MarkDannemiller/THOR-Glove/250228-150111-teensy40/docs/SCH_GLOVE-PCB_2025-04-27.pdf

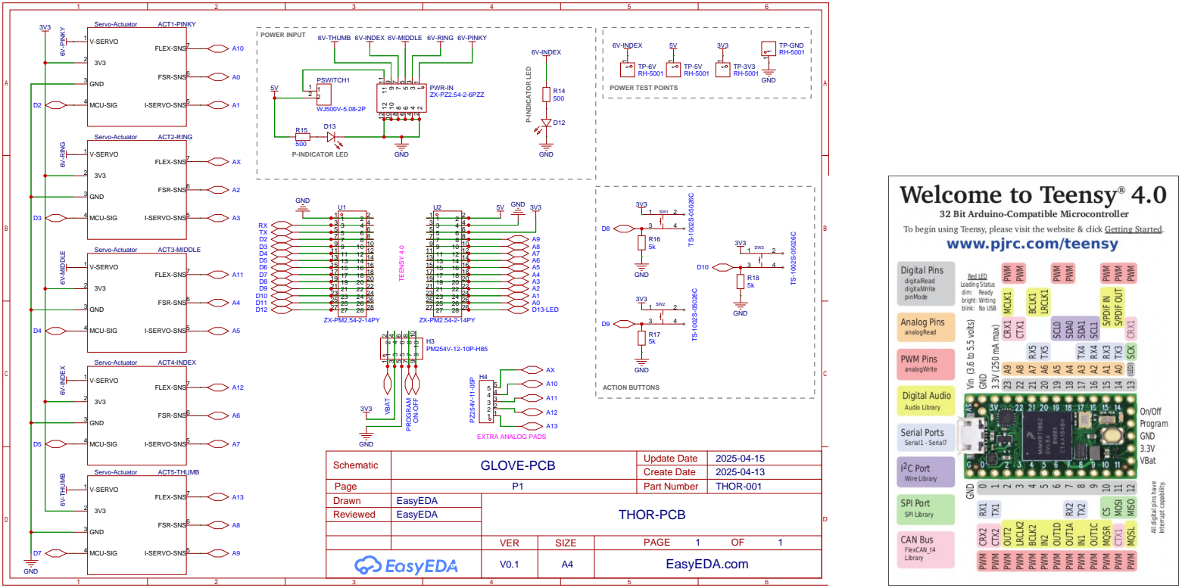
[picture p12: page 1]

6V-THUMB 6V-INDEX 6V-MIDDLE 6V-RING 6V-PINKY

6V-RING 6V-MIDDLE 6V-INDEX 6V-THUMB

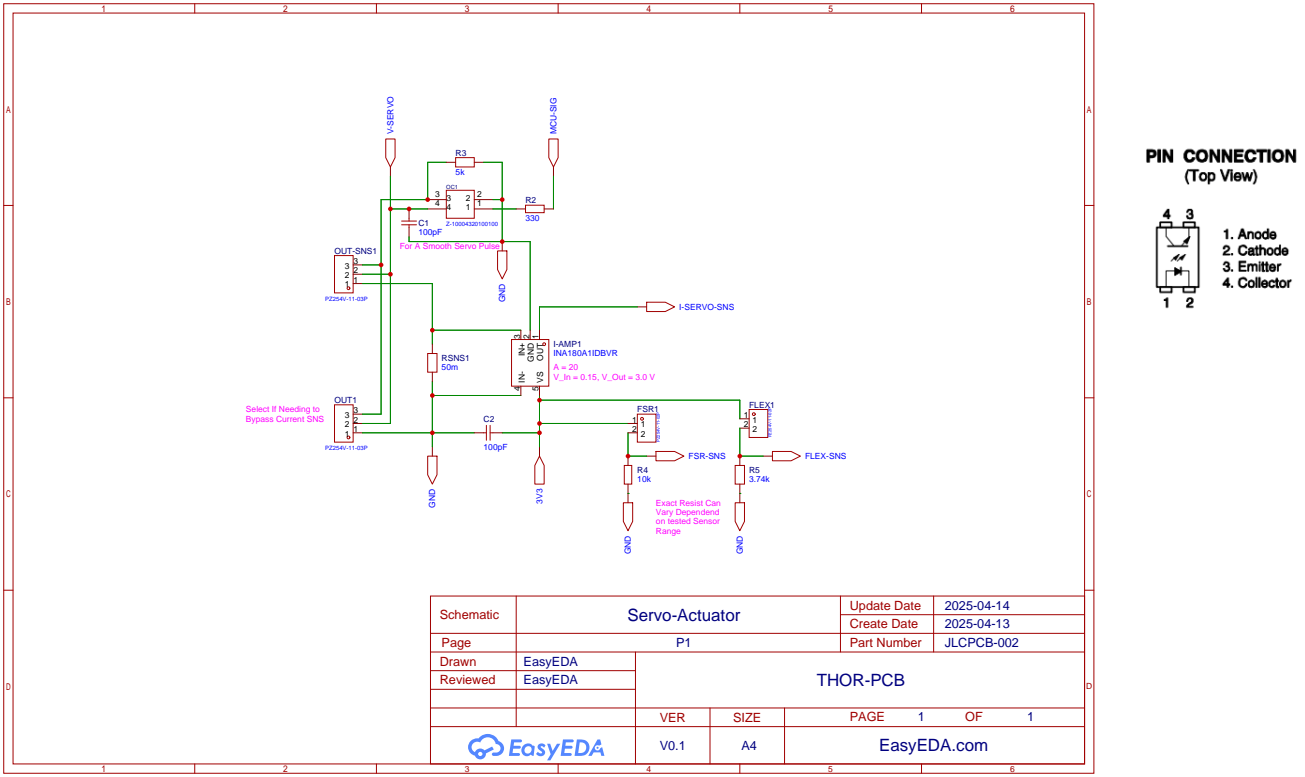
[picture p13: page 2]

Select If Needing to
Bypass Current SNS

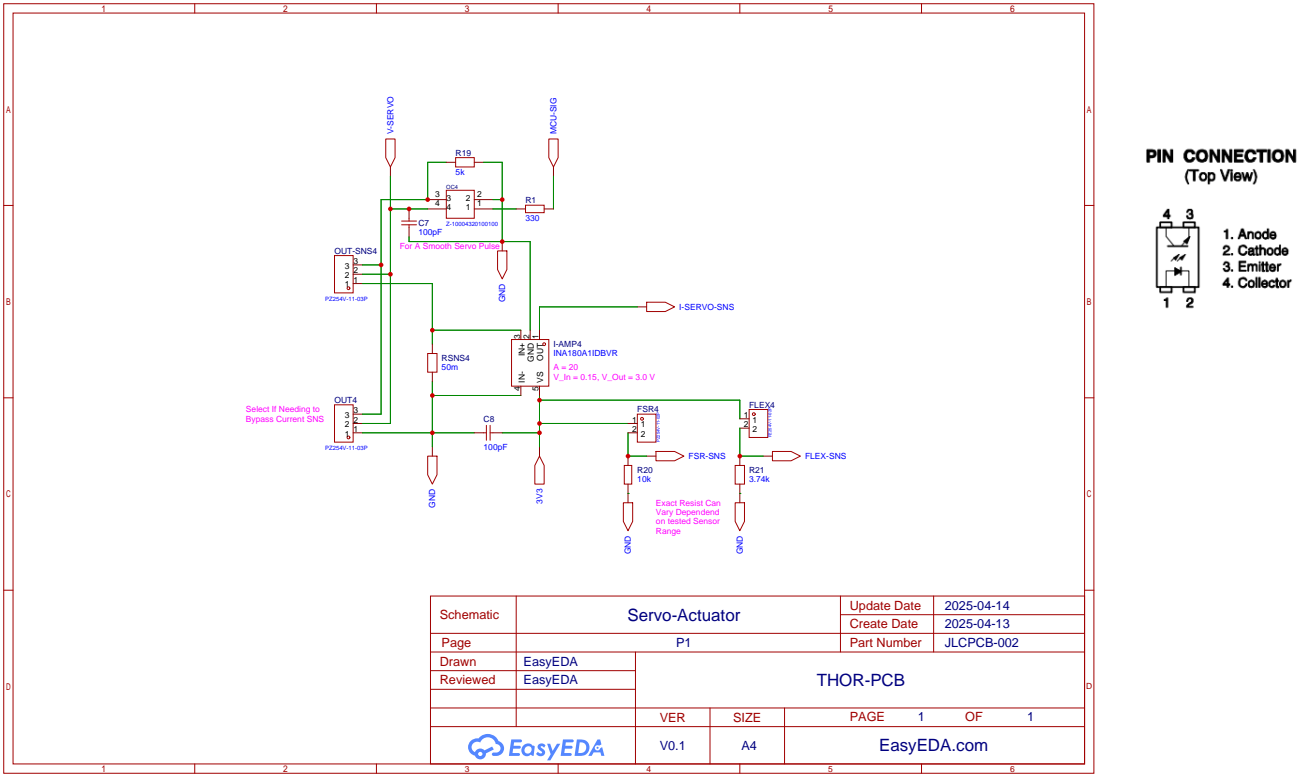
[picture p14: page 3]

Select If Needing to
Bypass Current SNS

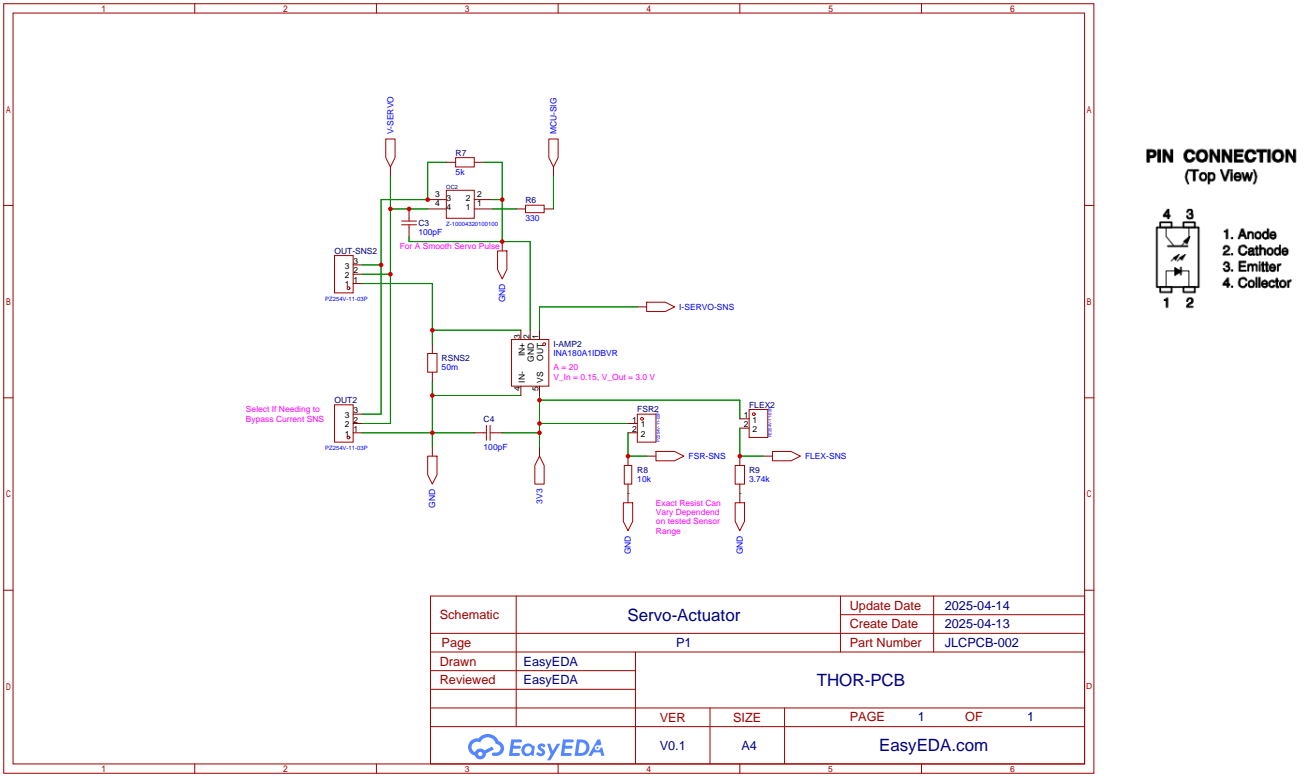
[picture p15: page 4]

Select If Needing to
Bypass Current SNS

Select If Needing to
Bypass Current SNS

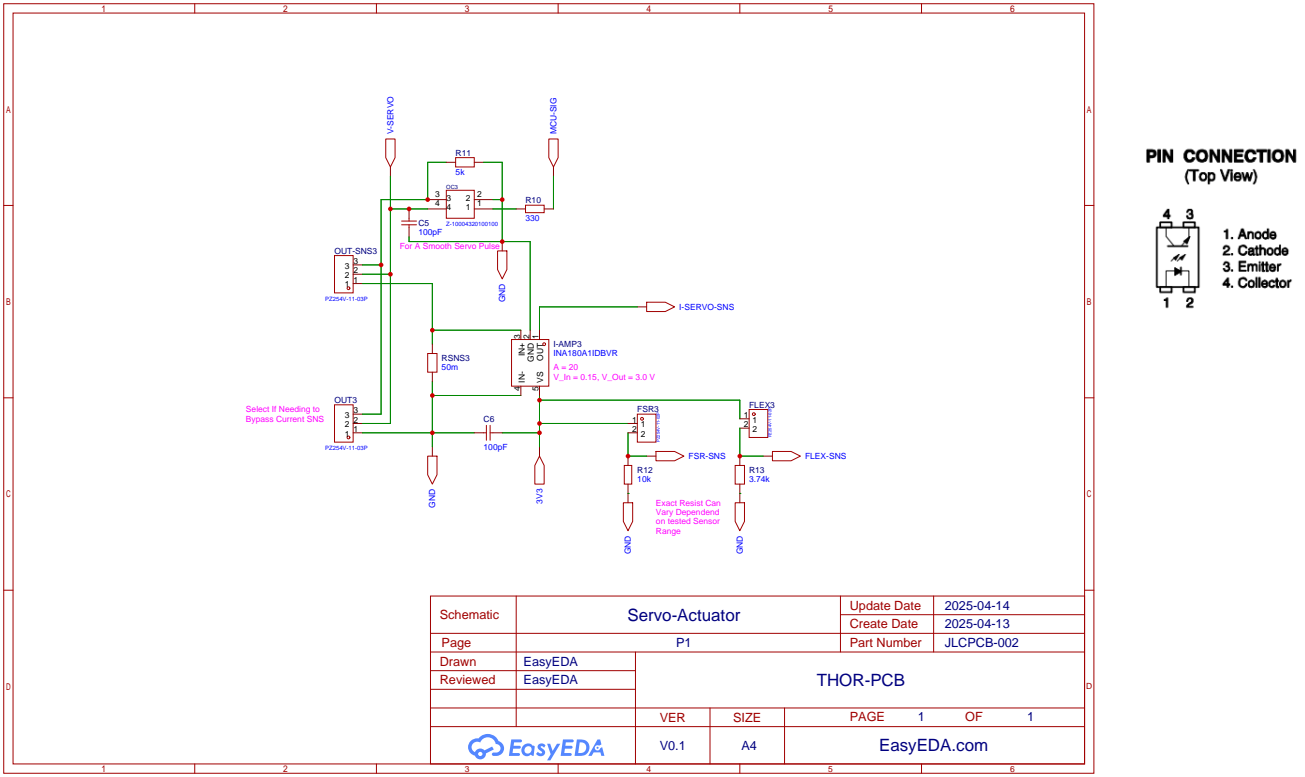
[picture p16: page 6]

Select If Needing to
Bypass Current SNS
