MarkDannemiller/THOR-Glove/(commit log)

2025-02-19 fixed errors and set resistor value
2025-02-20 implement code for prototype rig
2025-04-14 opamp-servo added
2025-04-27 pin assignments & buttons
2025-04-28 updated pointer demo for PCB
2025-04-30 add finger class for managing actuator and sensors
2025-05-05 calibrated limits
